saurabh-git-dev/CerealFilamentLid/v2/tools/preview_driver.png

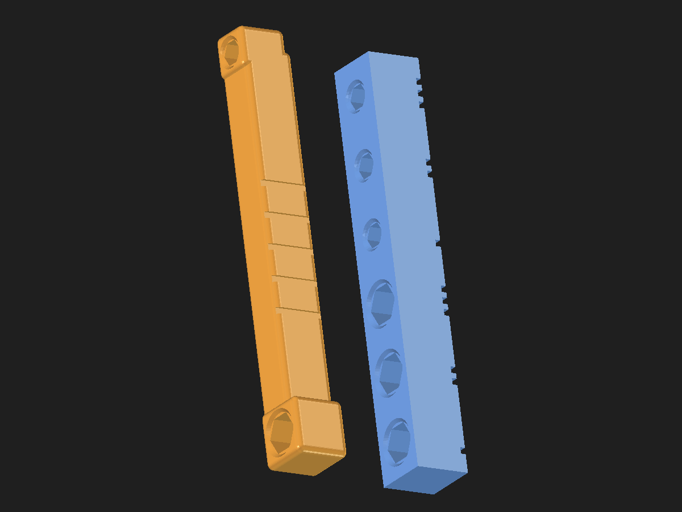
v2/tools/preview_driver.png
