saurabh-git-dev/CerealFilamentLid/v2/CerealLid_v2.FCStd

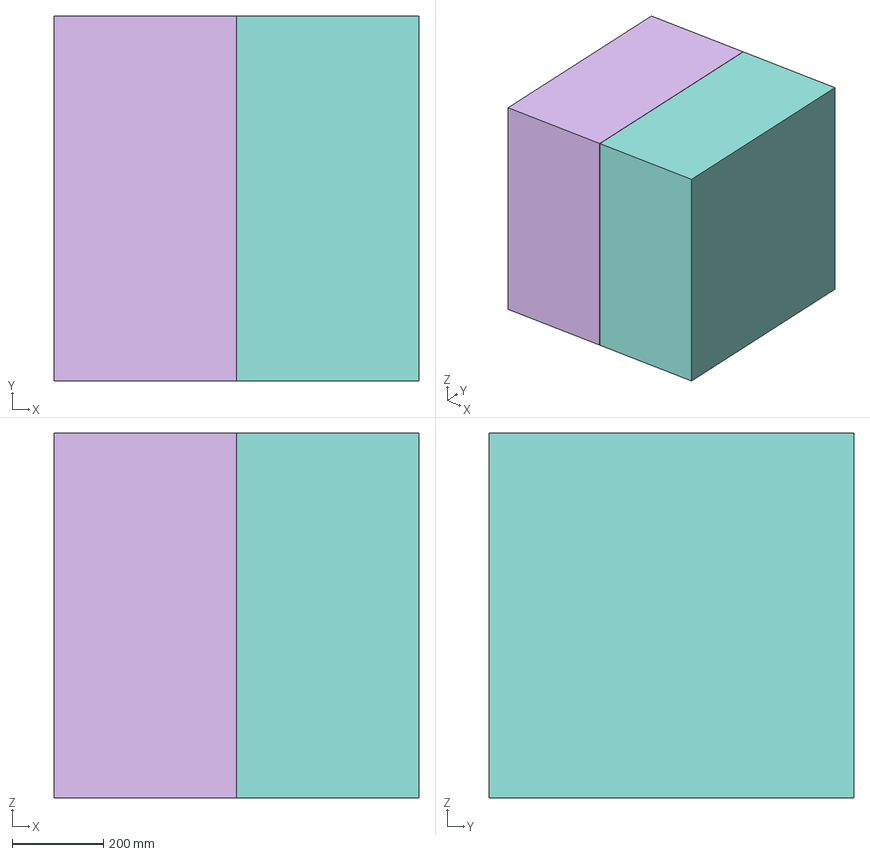
[picture p2: CAD file, 2026-10-28]
v2/CerealLid_v2.FCStd
800.0 x 800.0 x 800.0 mm
BoxRef
Lid
Latch x 5
Gasket
Lid_L
Lid_L_Cutter
Lid_R
Lid_R_Cutter
SeamStrip
SeamStrip_Cutter
Hanger_B
Hanger_A
HubHalfA x 2
HubHalfB x 2
HubRetainer x 3
StubAxle x 3
StubClip x 3
SilicaBox_L
SilicaBoxCover_L
SilicaBox_R
SilicaBoxCover_R
LockBolt x 7
SilicaBoxHandle
Grommet x 2
CapTether x 2
HygroCradle
