saurabh-git-dev/CerealFilamentLid/v2/stl_cereal/HygroCradle_Mini.stl

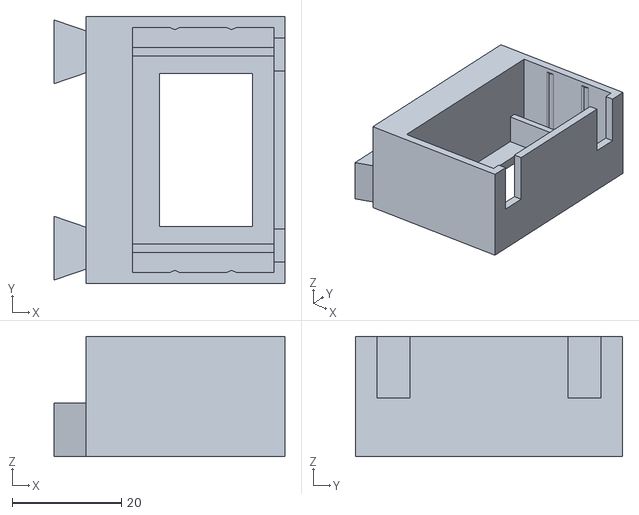
[picture p4: CAD file, 2026-10-28]
v2/stl_cereal/HygroCradle_Mini.stl
42.3 x 49.0 x 22.0
