saurabh-git-dev/CerealFilamentLid/v2/tools/Tool_BitDriver_Dual_FitTest_PETG_A1mini.3mf

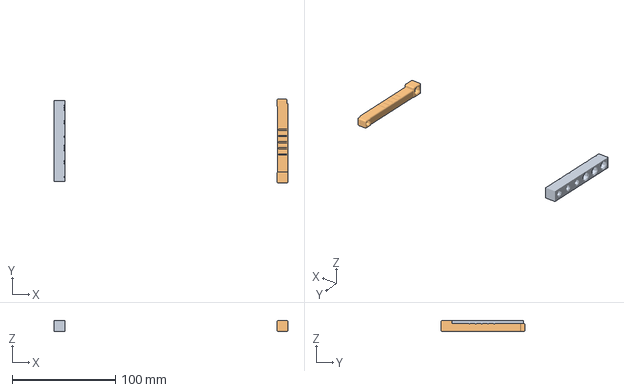
[picture p5: CAD file, 2026-10-28]
v2/tools/Tool_BitDriver_Dual_FitTest_PETG_A1mini.3mf
226.6 x 81.4 x 10.8 mm
Tool_BitSocket_FitTest_1
Tool_BitDriver_Dual_1
