saurabh-git-dev/CerealFilamentLid/v2/print/CerealLid_v2_Hub_only_PETG_A1mini.3mf

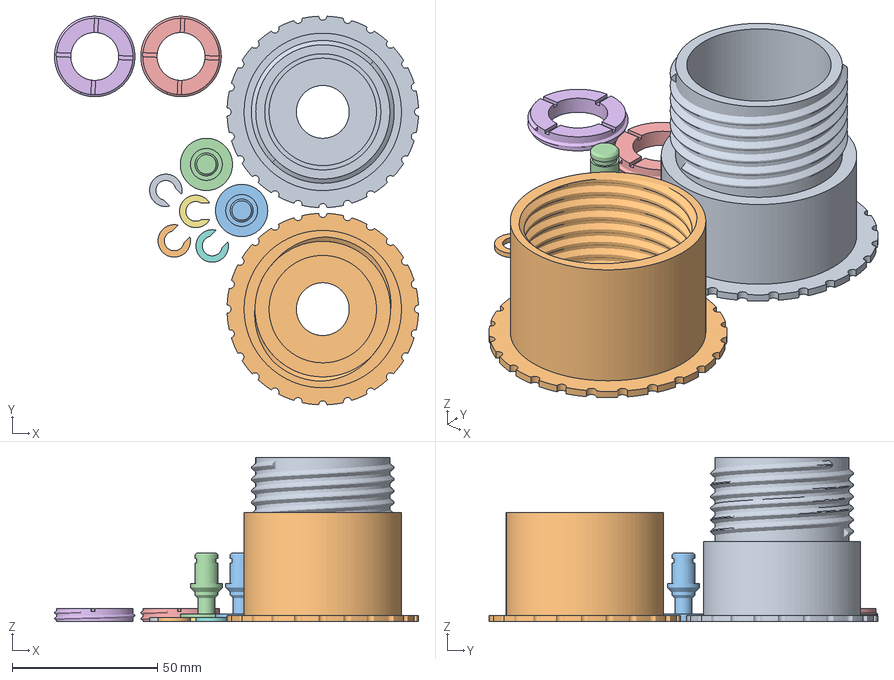
[picture p6: CAD file, 2026-10-28]
v2/print/CerealLid_v2_Hub_only_PETG_A1mini.3mf
125.4 x 133.9 x 56.5 mm
HubHalf_A_1
HubHalf_B_1
StubAxle_x2_1
StubAxle_x2_2
HubRetainer_x2_1
HubRetainer_x2_2
StubClip_x2_1
StubClip_x2_2
StubClip_x2_3
StubClip_x2_4
