saurabh-git-dev/CerealFilamentLid/v2/stl_cereal/TPU_Grommet.stl

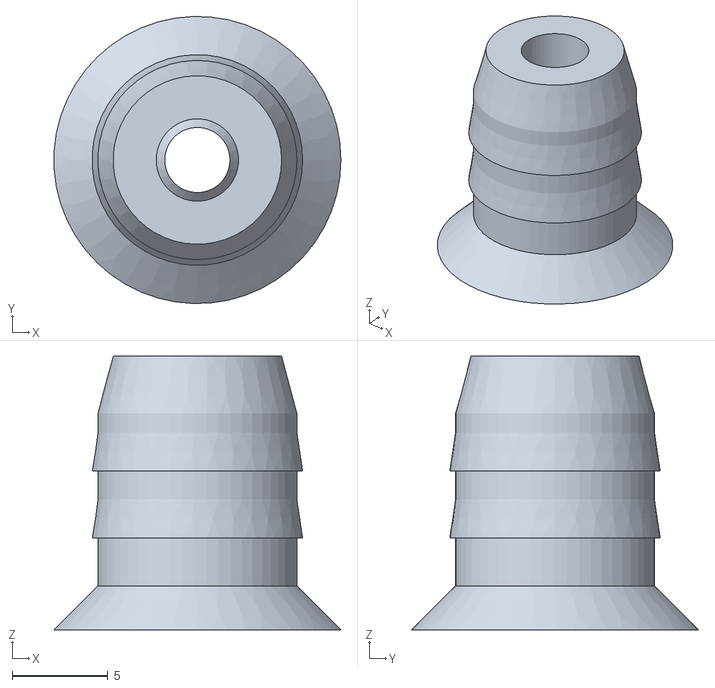
[picture p7: CAD file, 2026-10-28]
v2/stl_cereal/TPU_Grommet.stl
15.0 x 15.0 x 14.3
