saurabh-git-dev/CerealFilamentLid/v2/tools/Tool_BitDriver_Dual.stl

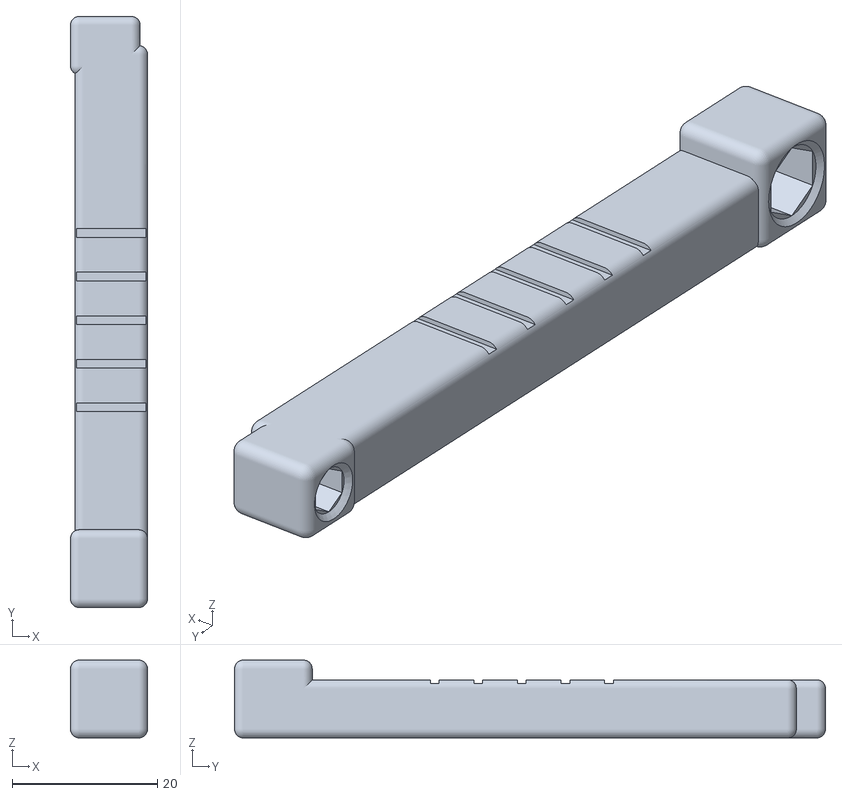
[picture p8: CAD file, 2026-10-28]
v2/tools/Tool_BitDriver_Dual.stl
10.6 x 81.4 x 10.7
