saurabh-git-dev/CerealFilamentLid/v2/print/CerealLid_v2_PETG_A1mini.3mf

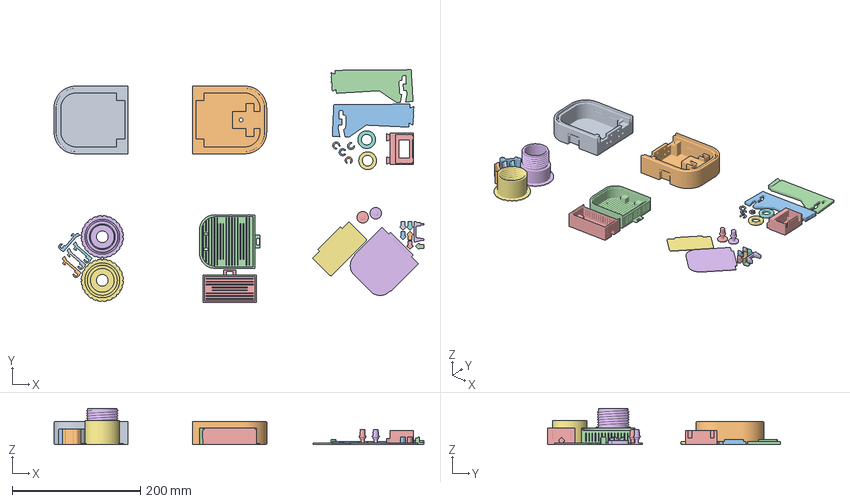
[picture p9: CAD file, 2026-10-28]
v2/print/CerealLid_v2_PETG_A1mini.3mf
576.6 x 363.1 x 56.5 mm
Lid_L_1
Lid_R_1
Hanger_A_1
Hanger_B_1
StubAxle_x2_1
StubAxle_x2_2
HubRetainer_x2_1
HubRetainer_x2_2
StubClip_x2_1
StubClip_x2_2
StubClip_x2_3
StubClip_x2_4
HygroCradle_Mini_1
HubHalf_A_1
HubHalf_B_1
Latch_x4_1
Latch_x4_2
Latch_x4_3
Latch_x4_4
SilicaBox_L_1
SilicaBox_R_1
SilicaBoxCover_L_1
SilicaBoxCover_R_1
SilicaLockBolt_x6_1
SilicaLockBolt_x6_2
SilicaLockBolt_x6_3
SilicaLockBolt_x6_4
SilicaLockBolt_x6_5
SilicaLockBolt_x6_6
SilicaBoxHandle_v2_1
