saurabh-git-dev/CerealFilamentLid/v2/tools/Tool_BitSocket_FitTest.stl

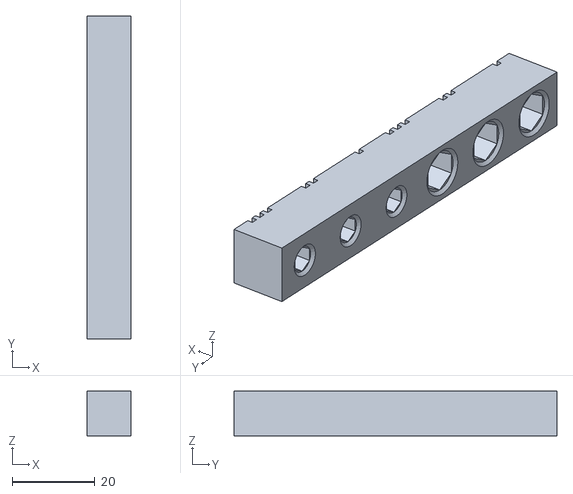
[picture p11: CAD file, 2026-10-28]
v2/tools/Tool_BitSocket_FitTest.stl
10.6 x 78.0 x 10.8
