saurabh-git-dev/CerealFilamentLid/v2/stl_cereal/TPU_CapTether.stl

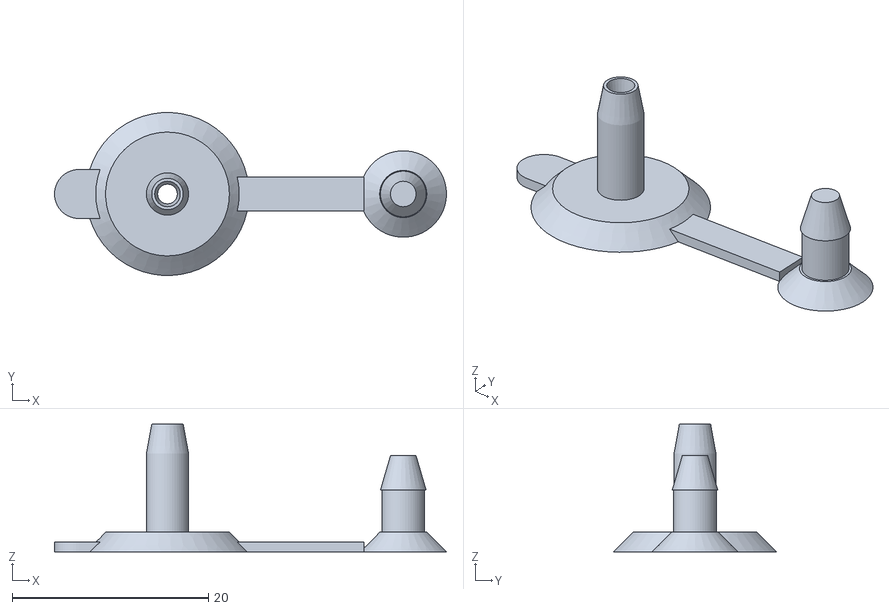
[picture p12: CAD file, 2026-10-28]
v2/stl_cereal/TPU_CapTether.stl
39.9 x 16.6 x 13.0
