saurabh-git-dev/CerealFilamentLid/v2/stl_cereal/Latch_x4.stl

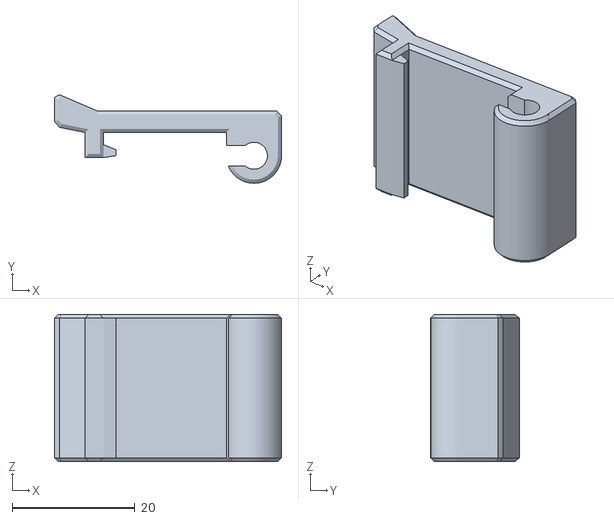
[picture p13: CAD file, 2026-10-28]
v2/stl_cereal/Latch_x4.stl
37.0 x 14.5 x 24.0
