saurabh-git-dev/CerealFilamentLid/v2/stl_cereal/SilicaBox_R.stl

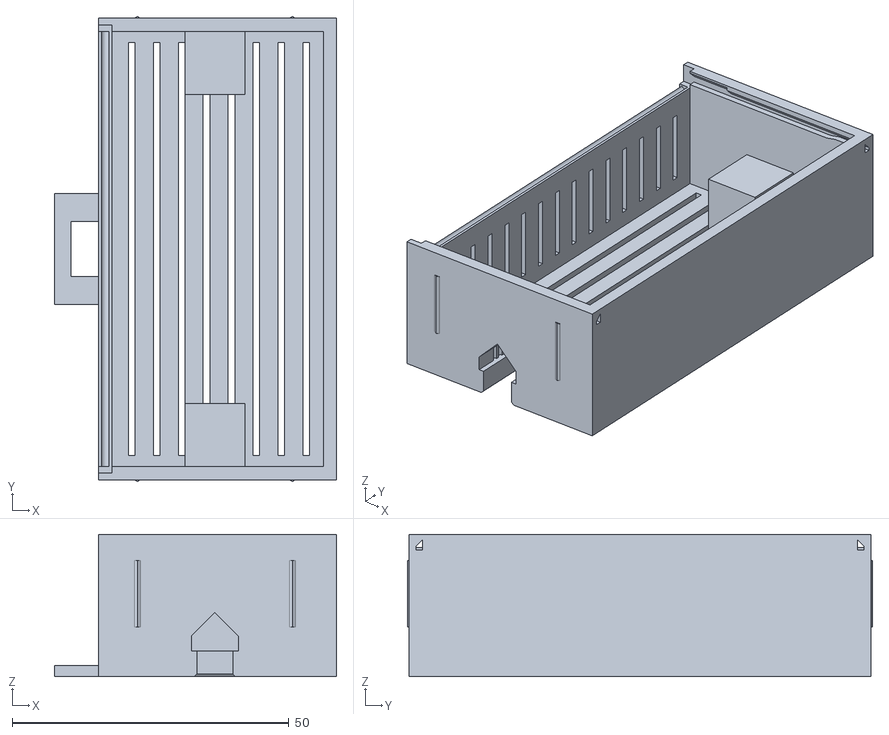
[picture p14: CAD file, 2026-10-28]
v2/stl_cereal/SilicaBox_R.stl
51.0 x 84.0 x 25.7
