saurabh-git-dev/CerealFilamentLid/v2/stl_cereal/StubAxle_x2.stl

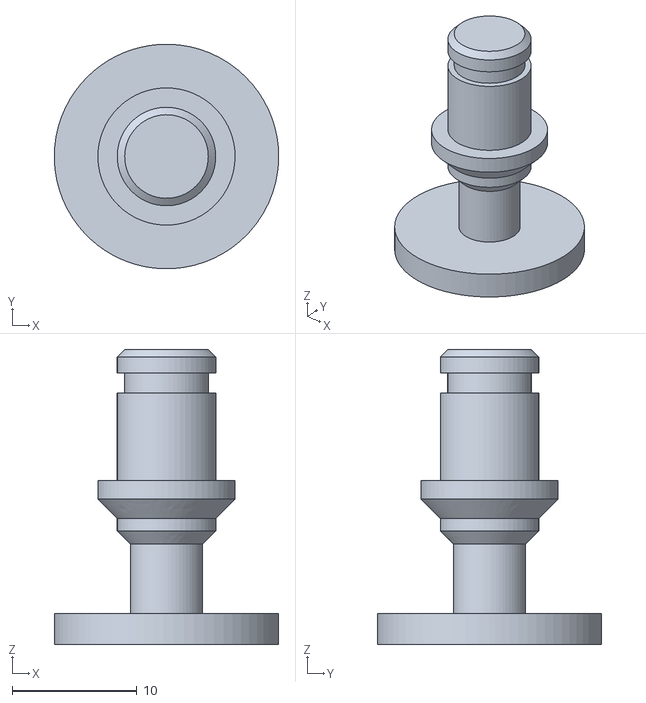
[picture p15: CAD file, 2026-10-28]
v2/stl_cereal/StubAxle_x2.stl
18.0 x 18.0 x 23.6
