saurabh-git-dev/CerealFilamentLid/v2/stl_cereal/HubRetainer_x2.stl

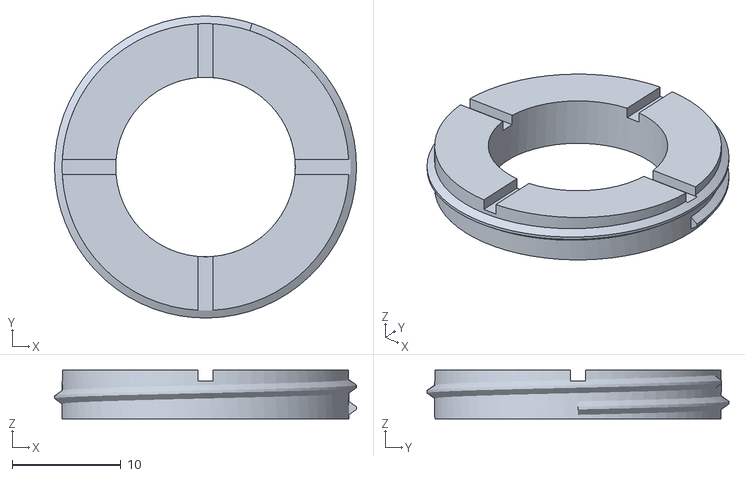
[picture p16: CAD file, 2026-10-28]
v2/stl_cereal/HubRetainer_x2.stl
27.7 x 27.7 x 4.50
