saurabh-git-dev/CerealFilamentLid/v2/stl_cereal/SilicaBoxHandle_v2.stl

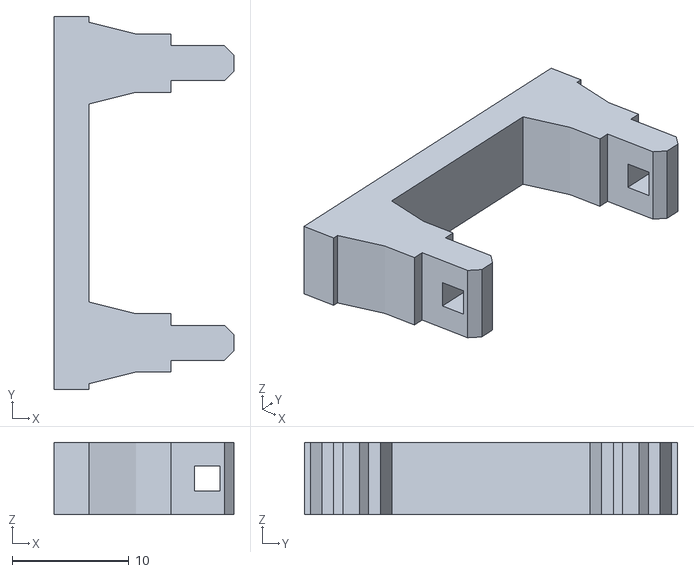
[picture p17: CAD file, 2026-10-28]
v2/stl_cereal/SilicaBoxHandle_v2.stl
15.4 x 32.0 x 6.20
