saurabh-git-dev/CerealFilamentLid/v2/stl_cereal/SilicaBoxCover_L.stl

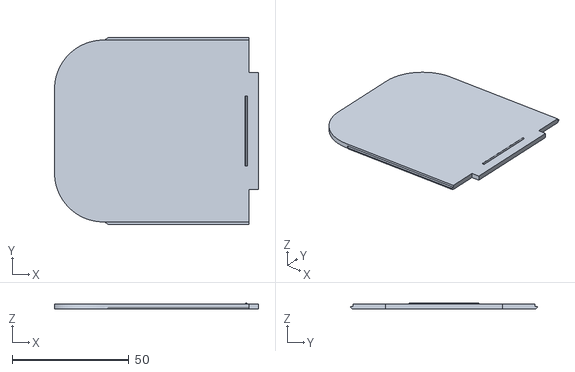
[picture p18: CAD file, 2026-10-28]
v2/stl_cereal/SilicaBoxCover_L.stl
87.5 x 80.4 x 2.69
