saurabh-git-dev/CerealFilamentLid/v2/stl_cereal/SilicaBoxCover_R.stl

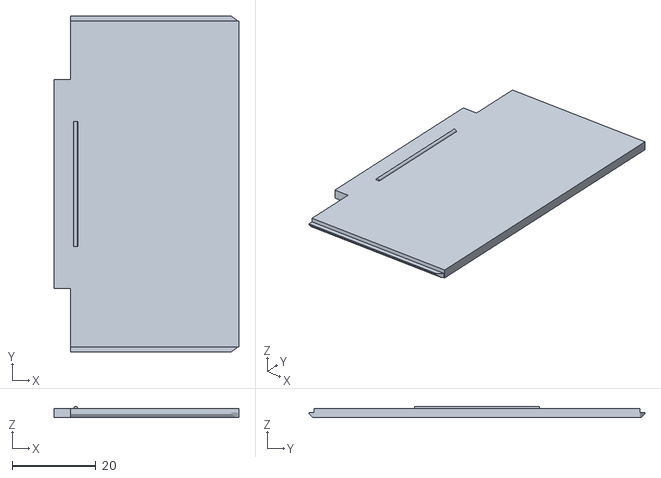
[picture p19: CAD file, 2026-10-28]
v2/stl_cereal/SilicaBoxCover_R.stl
44.3 x 80.4 x 2.69
