saurabh-git-dev/CerealFilamentLid/v2/stl_cereal/Lid_L.stl

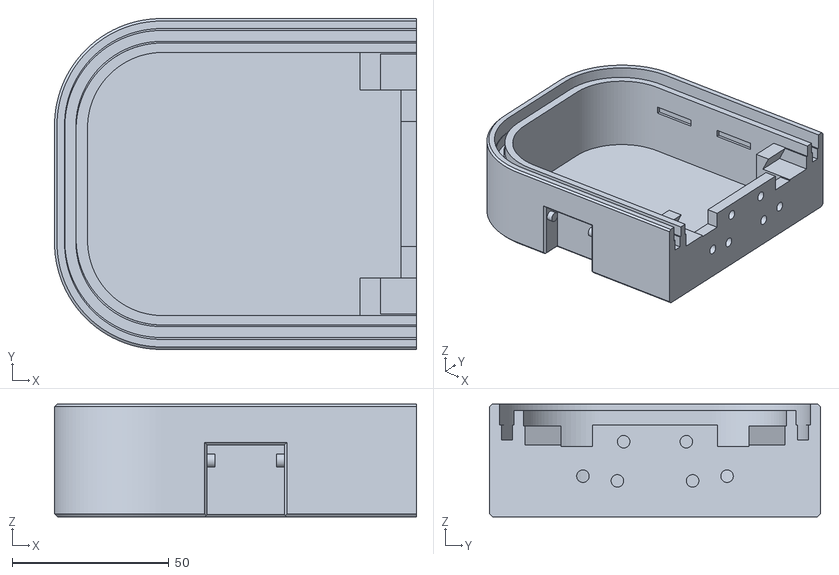
[picture p20: CAD file, 2026-10-28]
v2/stl_cereal/Lid_L.stl
115.6 x 105.6 x 36.0
