saurabh-git-dev/CerealFilamentLid/v2/stl_cereal/StubClip_x2.stl

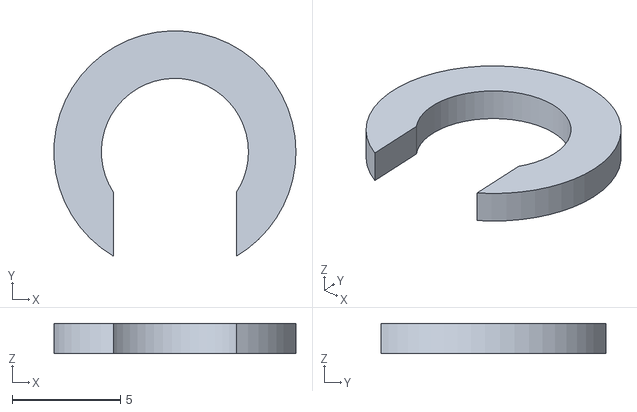
[picture p21: CAD file, 2026-10-28]
v2/stl_cereal/StubClip_x2.stl
11.2 x 10.4 x 1.40
