saurabh-git-dev/CerealFilamentLid/v2/stl_cereal/TPU_SeamStrip.stl

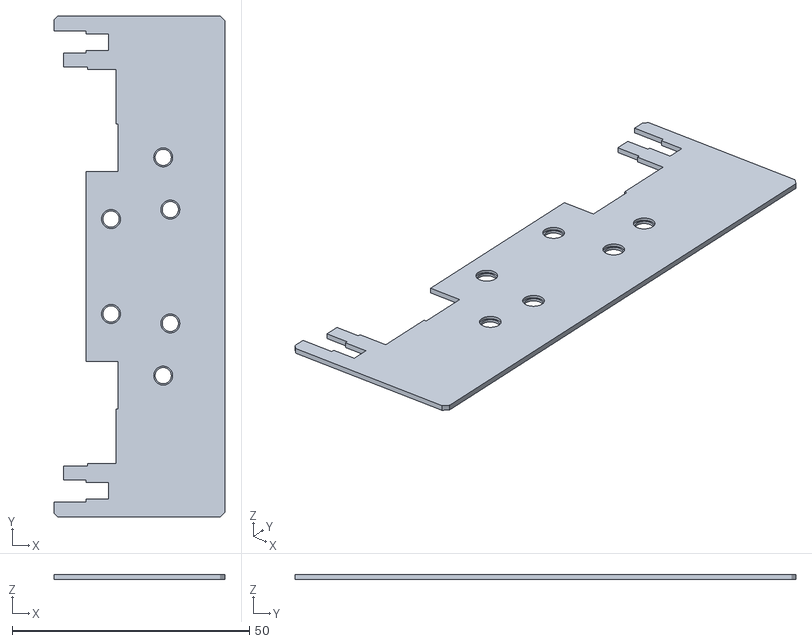
[picture p22: CAD file, 2026-10-28]
v2/stl_cereal/TPU_SeamStrip.stl
36.0 x 105.6 x 1.00
