saurabh-git-dev/CerealFilamentLid/v2/stl_cereal/Hanger_B.stl

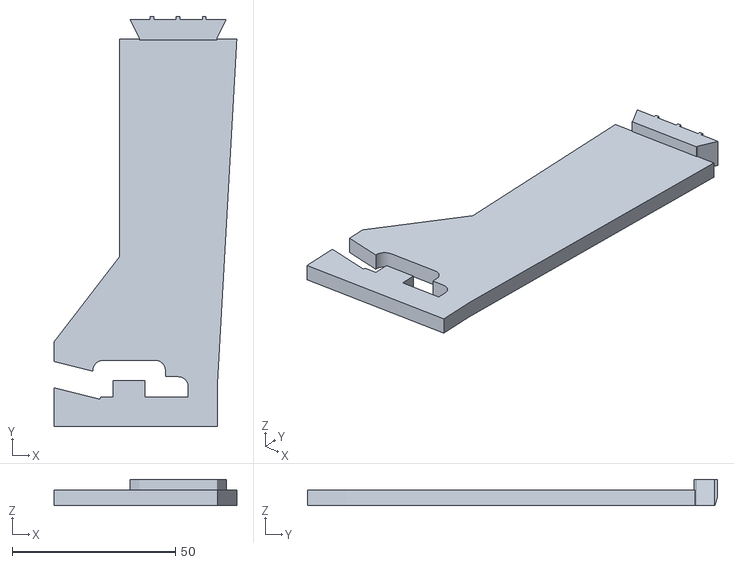
[picture p23: CAD file, 2026-10-28]
v2/stl_cereal/Hanger_B.stl
56.0 x 125.7 x 8.00
