saurabh-git-dev/CerealFilamentLid/v2/stl_cereal/HubHalf_B.stl

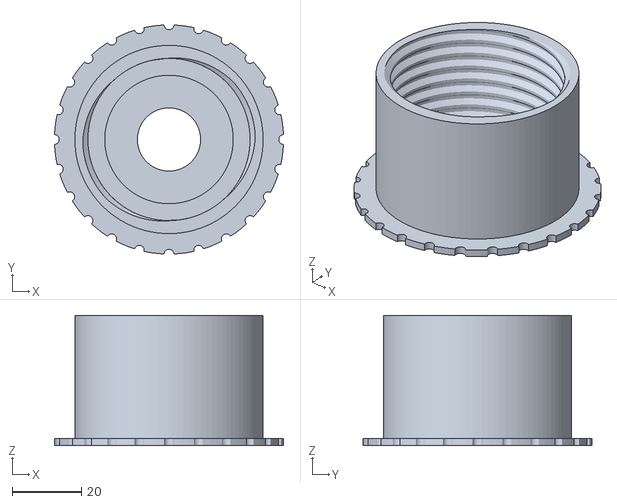
[picture p24: CAD file, 2026-10-28]
v2/stl_cereal/HubHalf_B.stl
65.9 x 65.9 x 37.5
