saurabh-git-dev/CerealFilamentLid/v2/stl_cereal/HubHalf_A.stl

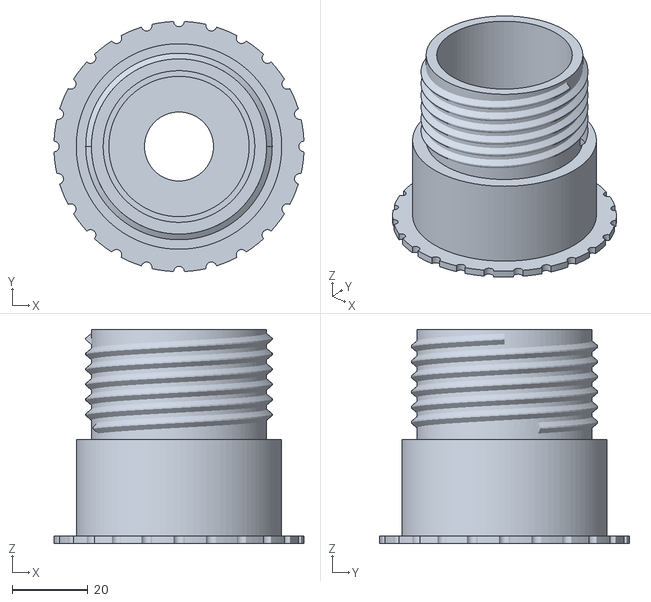
[picture p25: CAD file, 2026-10-28]
v2/stl_cereal/HubHalf_A.stl
65.9 x 65.9 x 56.5
