saurabh-git-dev/CerealFilamentLid/v2/stl_cereal/SilicaBox_L.stl

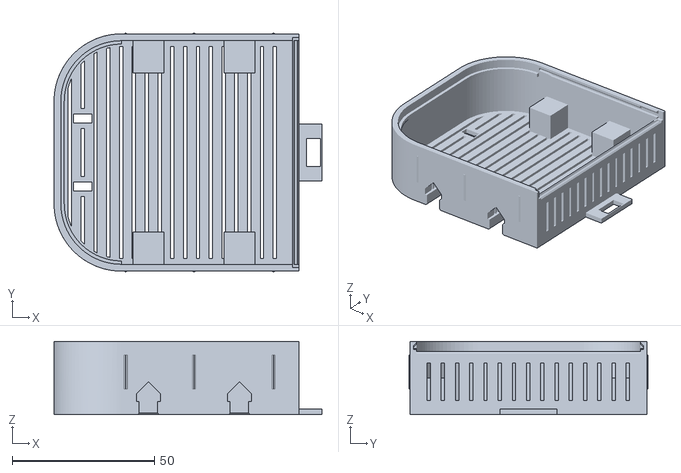
[picture p26: CAD file, 2026-10-28]
v2/stl_cereal/SilicaBox_L.stl
94.2 x 84.0 x 25.7
