saurabh-git-dev/CerealFilamentLid/(list of files, cad)

Other CAD files:
v2/stl_cereal/Hanger_A.stl
v1/print/CerealLid_v1_Hygro_OldCradle_Shim_PETG_A1mini.3mf
v1/print/CerealLid_v1_PETG_A1mini.3mf
v1/print/CerealLid_v1_TPU_eSUN_A1mini.3mf
v1/source/CerealLid.FCStd
v1/source/stl_cereal/Axle_8mm_x88.stl
v1/source/stl_cereal/Axle_8mm_x88_Grip.stl
v1/source/stl_cereal/Axle_8mm_x88_SpringStops.stl
v1/source/stl_cereal/Hanger_A.stl
v1/source/stl_cereal/Hanger_B.stl
v1/source/stl_cereal/HubAdapter_x2.stl
v1/source/stl_cereal/HygroCradle_50x50.stl
v1/source/stl_cereal/HygroCradle_Mini.stl
v1/source/stl_cereal/HygroCradle_Old_48x28.stl
v1/source/stl_cereal/HygroShim_OldCradle.stl
v1/source/stl_cereal/Latch_x4.stl
v1/source/stl_cereal/Lid_L.stl
v1/source/stl_cereal/Lid_R.stl
v1/source/stl_cereal/SilicaBoxCover_L.stl
v1/source/stl_cereal/SilicaBoxCover_R.stl
v1/source/stl_cereal/SilicaBoxHandle.stl
v1/source/stl_cereal/SilicaBoxHandle_v2.stl
v1/source/stl_cereal/SilicaBox_L.stl
v1/source/stl_cereal/SilicaBox_R.stl
v1/source/stl_cereal/SilicaHandleLockBar.stl
v1/source/stl_cereal/SilicaLockBolt_x6.stl
v1/source/stl_cereal/SilicaPuller.stl
v1/source/stl_cereal/SlideHanger_A.stl
v1/source/stl_cereal/SlideHanger_B.stl
v1/source/stl_cereal/SliderLockPlate_x2.stl
v1/source/stl_cereal/Slider_A.stl
v1/source/stl_cereal/Slider_B.stl
v1/source/stl_cereal/SnapHanger_A.stl
v1/source/stl_cereal/SnapHanger_B.stl
v1/source/stl_cereal/SpringHanger_A.stl
v1/source/stl_cereal/SpringHanger_B.stl
v1/source/stl_cereal/SpringLockPlate_x2.stl
v1/source/stl_cereal/SpringSlider_A.stl
v1/source/stl_cereal/SpringSlider_B.stl
v1/source/stl_cereal/SpringTest_AxleStub.stl
v1/source/stl_cereal/SpringTest_ChannelSlice.stl
v1/source/stl_cereal/SpringTest_HangerSection.stl
v1/source/stl_cereal/TPU_CapTether.stl
v1/source/stl_cereal/TPU_Gasket_L.stl
v1/source/stl_cereal/TPU_Gasket_R.stl
v1/source/stl_cereal/TPU_Grommet.stl
v1/source/stl_cereal/TPU_SeamStrip.stl
v1/source/stl_cereal/Test_Corner.stl
v1/source/stl_cereal/Test_HangerFit2_g0.15_1notch.stl
v1/source/stl_cereal/Test_HangerFit2_g0.25_2notch.stl
v1/source/stl_cereal/Test_HangerFit2_g0.35_3notch.stl
v1/source/stl_cereal/Test_LatchSection.stl
v1/stl/Axle_8mm_x88_Grip.stl
v1/stl/Hanger_A.stl
v1/stl/Hanger_B.stl
v1/stl/HubAdapter_x2.stl
v1/stl/HygroCradle_NoSupport.stl
v1/stl/HygroCradle_Old_48x28.stl
v1/stl/HygroShim_OldCradle.stl
v1/stl/Latch_x4.stl
v1/stl/Lid_L.stl
v1/stl/Lid_R.stl
v1/stl/SilicaBoxCover_L.stl
v1/stl/SilicaBoxCover_R.stl
v1/stl/SilicaBoxHandle_v2.stl
v1/stl/SilicaBox_L.stl
v1/stl/SilicaBox_R.stl
v1/stl/SilicaLockBolt_x6.stl
v1/stl/TPU_CapTether.stl
v1/stl/TPU_Grommet.stl
v1/stl/TPU_SeamStrip.stl
v1/tools/Tool_BitDriver_PETG_A1mini.3mf
v2/stl_cereal/SilicaLockBolt_x6.stl
